EstebanValverde/Tetroplater/block diagram.png

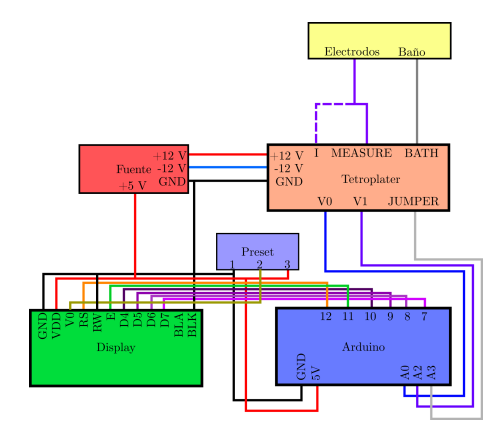
block diagram.png
